BriefJosh/microwave-ablation-antenna/pcb_stackup/stackup_comparison.pdf

### JLCPCB 4-layer

Cu 0.035
Prepreg 0.2104
L2 Cu 0.0152
Core 0.25
L3 Cu 0.0152
Prepreg 0.2104
Cu 0.035
Σ 0.771
7628; εr 4.4/4.23/4.4

### This work

Cu 0.035
Prepreg 0.2104
L2 Cu 0.0152
Core 0.25

Prepreg 0.2104
Cu 0.035
Σ 0.756
L3 empty; εr 4.4/4.23/4.4

### Wen 2021

Cu 0.035
FR-4 0.2
Cu 0.0175
Bond 0.265

FR-4 0.2
Cu 0.035
Σ 0.753
εr 4.8 (one FR-4 value)

### Wang 2022

Cu 0.035

F4B-1/2 0.5

Cu 0.035

F4B-1/2 0.5

Cu 0.035
Σ 1.105
εr 2.55

### Fang 2025

Cu n/r

F4B-1/2 0.5

Bond n/r

F4B-1/2 0.5

Cu n/r
Σ n/r
εr 2.55; inner Cu n/r

Lu 2026

FR-4 0.2
Cu 0.035
FR-4 0.2
Cu 0.035
FR-4 0.2
Cu 0.035
FR-4 0.2

Σ 0.905
εr 4.4
