BriefJosh/microwave-ablation-antenna/pcb_stackup/jlcpcb_4layer_0p8mm/JLC04081H-1080.png

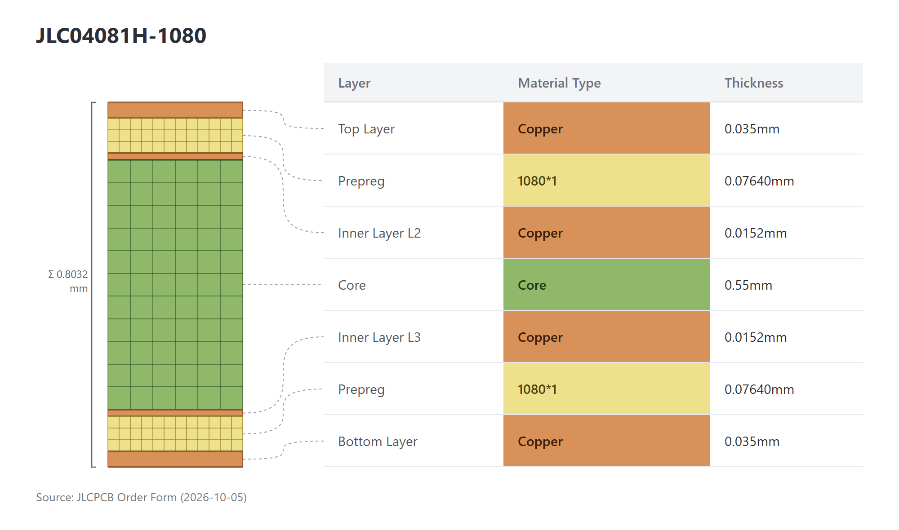
pcb_stackup/jlcpcb_4layer_0p8mm/JLC04081H-1080.png
