BriefJosh/microwave-ablation-antenna/antenna/results/comsol_baseline13t_tbc_i7.csv

% freq_Hz | re | im
2.300000000000000000e+09 | -3.353960087246685151e-01 | 4.917989875658924648e-01
2.325000000000000000e+09 | -2.439816931909648545e-01 | 4.760329906015924872e-01
2.350000000000000000e+09 | -1.509560617358955414e-01 | 4.246613617999355772e-01
2.375000000000000000e+09 | -7.446450746831664858e-02 | 3.299389897923941106e-01
2.400000000000000000e+09 | -4.223055281238448366e-02 | 1.966616296494839156e-01
2.425000000000000000e+09 | -7.906757249204013349e-02 | 5.275355444050418285e-02
2.450000000000000000e+09 | -1.839078100254551984e-01 | -5.734335948792297633e-02
2.475000000000000000e+09 | -3.233063981473703885e-01 | -1.018968215064014193e-01
2.500000000000000000e+09 | -4.558627165221541544e-01 | -8.150259566176183690e-02
2.525000000000000000e+09 | -5.570709586624726928e-01 | -1.792909439182069353e-02
2.550000000000000000e+09 | -6.216422033178112816e-01 | 6.575570601824584638e-02
2.575000000000000000e+09 | -6.541955325016477474e-01 | 1.540512226188826550e-01
2.600000000000000000e+09 | -6.617145799081768365e-01 | 2.387496933596718607e-01
