BriefJosh/microwave-ablation-antenna/antenna/results/comsol_smoke_m6.csv

% freq_Hz | re | im
2.450000000000000000e+09 | -2.209095195030213732e-01 | 4.743450082596920581e-01
