BriefJosh/microwave-ablation-antenna/antenna/results/comsol_sweep11_m6.csv

% freq_Hz | re | im
2.000000000000000000e+09 | -4.962986900155482717e-01 | -3.786495218690775523e-03
2.100000000000000000e+09 | -5.596730567500068920e-01 | 9.306660799492487424e-02
2.200000000000000000e+09 | -5.803480292951711528e-01 | 2.027627730429179265e-01
2.300000000000000000e+09 | -5.670564908709513352e-01 | 4.187563526511282608e-01
2.400000000000000000e+09 | -3.480754146372680435e-01 | 4.950880430054797610e-01
2.500000000000000000e+09 | -9.223517506862907722e-02 | 3.701385553146943064e-01
2.600000000000000000e+09 | -1.702786496190960008e-01 | -1.944763099739735962e-02
2.700000000000000000e+09 | -5.908406830734983517e-01 | 5.736447541678121181e-02
2.800000000000000000e+09 | -6.311148409285710636e-01 | 4.067320327016232251e-01
2.900000000000000000e+09 | -4.055738102663572486e-01 | 6.240830452259914507e-01
3.000000000000000000e+09 | -4.979227743683267704e-02 | 5.700086053435662325e-01
