BriefJosh/microwave-ablation-antenna/antenna/results/comsol_sweep11_tbc_m6.csv

% freq_Hz | re | im
2.000000000000000000e+09 | -5.096180128043801272e-01 | 1.784084244442485714e-02
2.100000000000000000e+09 | -5.604944882168424458e-01 | 1.118618002738900746e-01
2.200000000000000000e+09 | -5.799076911343323815e-01 | 2.108892781983210118e-01
2.300000000000000000e+09 | -5.411207111576400441e-01 | 4.071227184215541195e-01
2.400000000000000000e+09 | -3.414859206396744229e-01 | 4.762244550304169377e-01
2.500000000000000000e+09 | -1.160362345912032411e-01 | 3.398757844504047831e-01
2.600000000000000000e+09 | -2.250380745022158568e-01 | 4.399045296229737653e-03
2.700000000000000000e+09 | -5.844632152046885798e-01 | 1.033632021091454023e-01
2.800000000000000000e+09 | -6.066174670018372739e-01 | 4.166330385970165584e-01
2.900000000000000000e+09 | -3.952737530162887536e-01 | 6.081767261109032319e-01
3.000000000000000000e+09 | -7.813975714787861626e-02 | 5.487375371407016145e-01
