BriefJosh/microwave-ablation-antenna/antenna/results/convergence_base.csv

idx | n_elem | solve_s | f_Hz | re | im
7 | 235032 | 224.7 | 2500000000.0 | -0.08931798338344699 | 0.3555319367314642
7 | 235032 | 224.7 | 2550000000.0 | -0.06013812044745546 | 0.1479297080811668
7 | 235032 | 224.7 | 2600000000.0 | -0.2098117150628589 | -0.04094601376975219
7 | 235032 | 224.7 | 2650000000.0 | -0.4522438230137258 | -0.05572688439089809
7 | 235032 | 224.7 | 2700000000.0 | -0.6200262030524069 | 0.08320312217110551
6 | 279363 | 252.1 | 2500000000.0 | -0.0864907161854724 | 0.36096393844237756
6 | 279363 | 252.1 | 2550000000.0 | -0.045135122562042086 | 0.1653099170044796
6 | 279363 | 252.1 | 2600000000.0 | -0.17067518089397601 | -0.030443074394179554
6 | 279363 | 252.1 | 2650000000.0 | -0.40748086452299576 | -0.07299424624496856
6 | 279363 | 252.1 | 2700000000.0 | -0.5926944231813835 | 0.04829166198977512
5 | 364365 | 317.3 | 2500000000.0 | -0.10384200234565988 | 0.37271697407185544
5 | 364365 | 317.3 | 2550000000.0 | -0.05513202182915755 | 0.1858683853494692
5 | 364365 | 317.3 | 2600000000.0 | -0.16864272650547996 | -0.011068806625713669
5 | 364365 | 317.3 | 2650000000.0 | -0.40163454231012546 | -0.06263501250786901
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
