BriefJosh/microwave-ablation-antenna/antenna/results/convergence_flags.csv

idx | n_elem | solve_s | f_Hz | re | im
6 | 199134 | 155.8 | 2500000000.0 | -0.07514734198336921 | 0.3632132896985555
6 | 199134 | 155.8 | 2550000000.0 | -0.03567639714323558 | 0.168892060866179
6 | 199134 | 155.8 | 2600000000.0 | -0.16242836401106545 | -0.024990584416352265
6 | 199134 | 155.8 | 2650000000.0 | -0.40063646405118475 | -0.0647865659559437
6 | 199134 | 155.8 | 2700000000.0 | -0.5855901516908759 | 0.06120912444601777
