BriefJosh/microwave-ablation-antenna/antenna/results/liver_face_check_sweep11_tbc_m6.png

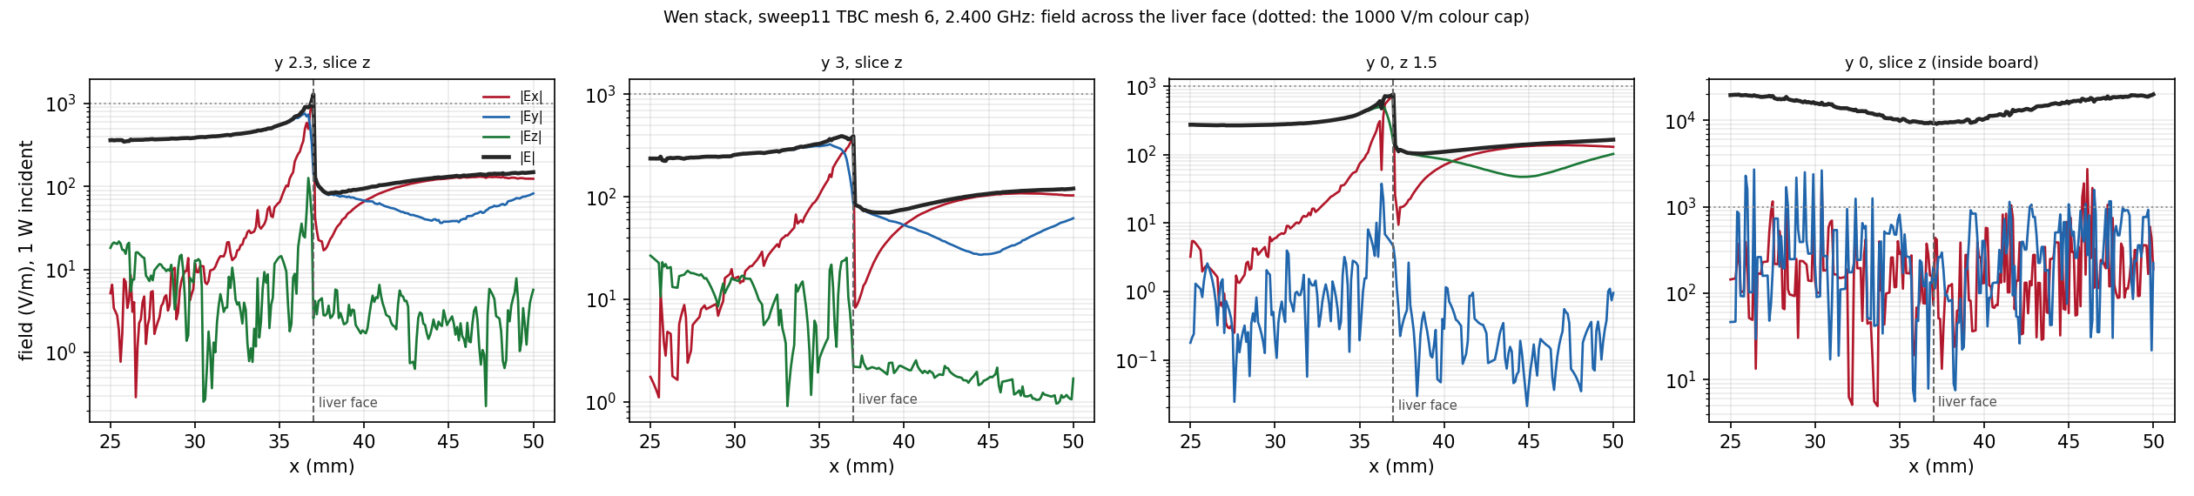
antenna/results/liver_face_check_sweep11_tbc_m6.png
