BriefJosh/microwave-ablation-antenna/(commit log)

2026-10-05 jlcpcb pcb research
2026-10-08 Add KiCad antenna layout screenshot
2026-10-08 Add KiCad antenna screenshot to README
2026-10-10 Antenna geometry: parameters with sources, layout shapes, layer stack, and the KiCad project with Gerbers of the Wen 2021 geometry
2026-10-11 COMSOL model of the Wen 2021 antenna: build, sweep, convergence and liver scans, with S11 results
2026-10-21 Helix via size: four via candidates on the retuned layout with a sharp arm bend, JLCPCB via rules and pre-solve checks, README section 9.4
